TurtleBot-Mfg/turtlebot-doc-dev/README.md

root/usr/share/doc/turtlebot-dev/README.md
