TurtleBot-Mfg/turtlebot-doc-dev/root/usr/share/doc/turtlebot-dev/README.md

# TurtleBot Open Source Hardware Documentation and Documentation Source files
----
This pakage contains OSHW documentation
and source files to build .pdfs for user doumentation and assembly guides
