TurtleBot-Mfg/turtlebot-doc-dev/root/usr/share/doc/turtlebot-dev/TurtleBot 2 Hardware/Mechanical Drawings/PDF/IHE-0100-0003-3300.pdf

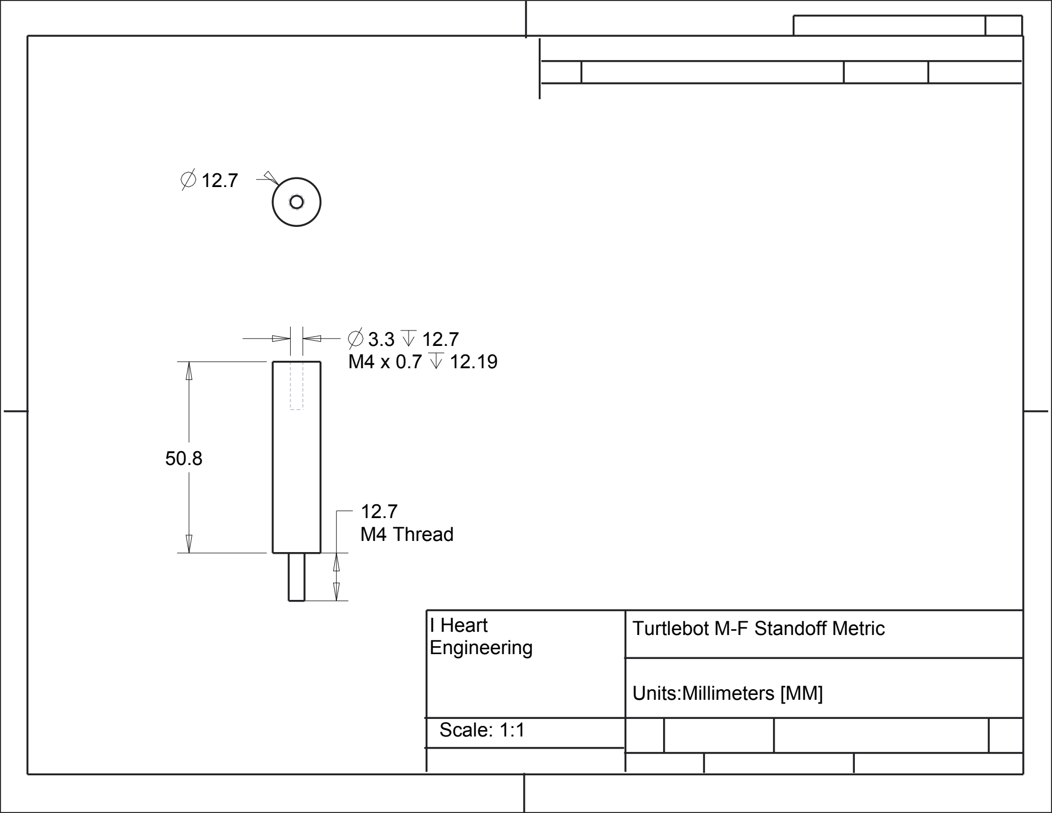
[picture p1: figure]
12.7 M4 Thread; I Heart; Turtlebot M-F Standoff Metric; Engineering; Units:Millimeters [MM]; Scale: 1:1
