TurtleBot-Mfg/turtlebot-doc-dev/root/usr/share/doc/turtlebot-dev/TurtleBot 2 Hardware/CAD Models/STEP/ITurtleBot2_plate1_HE-0102-000C-0000.stp

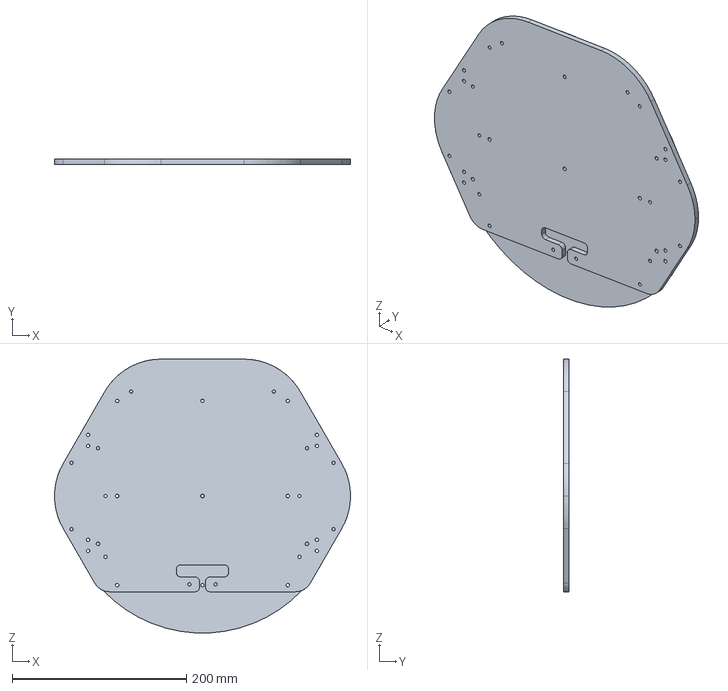
[picture p2: CAD file, 2013-01-17]
root/usr/share/doc/turtlebot-dev/TurtleBot 2 Hardware/CAD Models/STEP/ITurtleBot2_plate1_HE-0102-000C-0000.stp
340.0 x 6.40 x 314.5 mm
