TurtleBot-Mfg/turtlebot-doc-dev/root/usr/share/doc/turtlebot-dev/TurtleBot 2 Hardware/CAD Models/STL/IHE-0102-000C-0000.stl

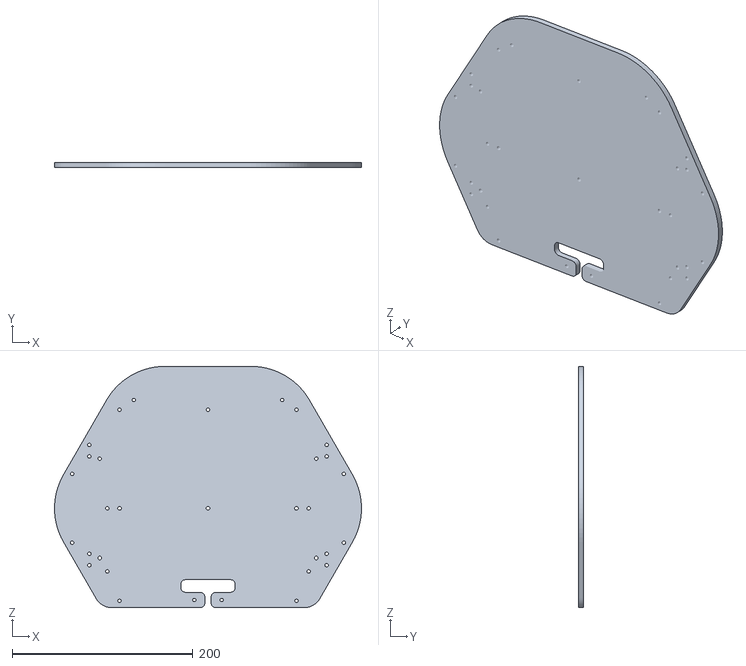
[picture p3: CAD file, 2013-01-17]
root/usr/share/doc/turtlebot-dev/TurtleBot 2 Hardware/CAD Models/STL/IHE-0102-000C-0000.stl
340.0 x 6.00 x 267.3
