TurtleBot-Mfg/turtlebot-doc-dev/root/usr/share/doc/turtlebot-dev/TurtleBot 2 Hardware/CAD Models/STEP/IHE-0100-0006-5300.stp

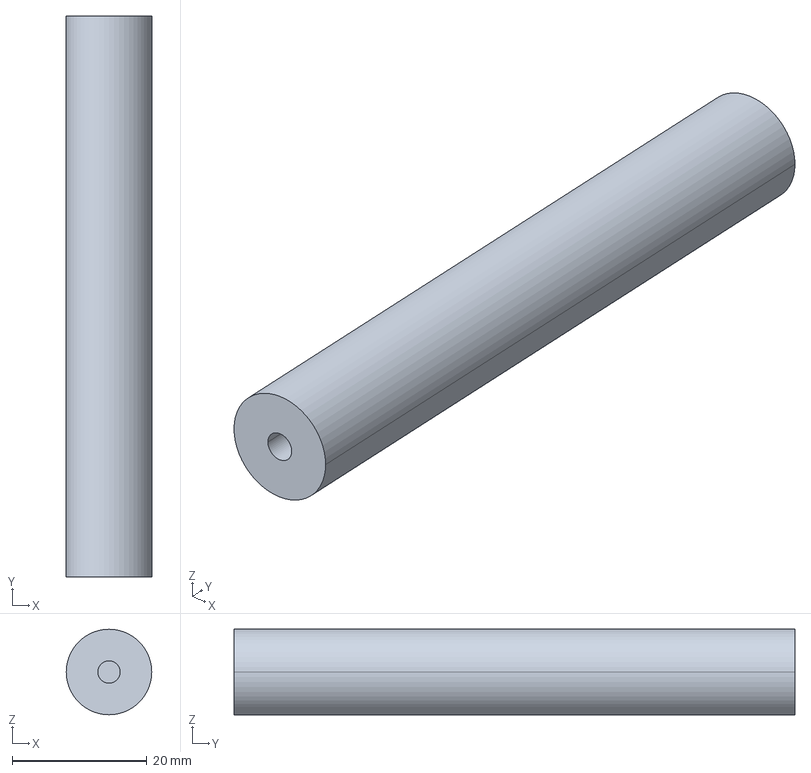
[picture p5: CAD file, 2013-01-17]
root/usr/share/doc/turtlebot-dev/TurtleBot 2 Hardware/CAD Models/STEP/IHE-0100-0006-5300.stp
12.7 x 83.3 x 12.7 mm
