TurtleBot-Mfg/turtlebot-doc-dev/root/usr/share/doc/turtlebot-dev/TurtleBot 2 Hardware/CAD Models/STEP/IHE-0100-0004-CB00.stp

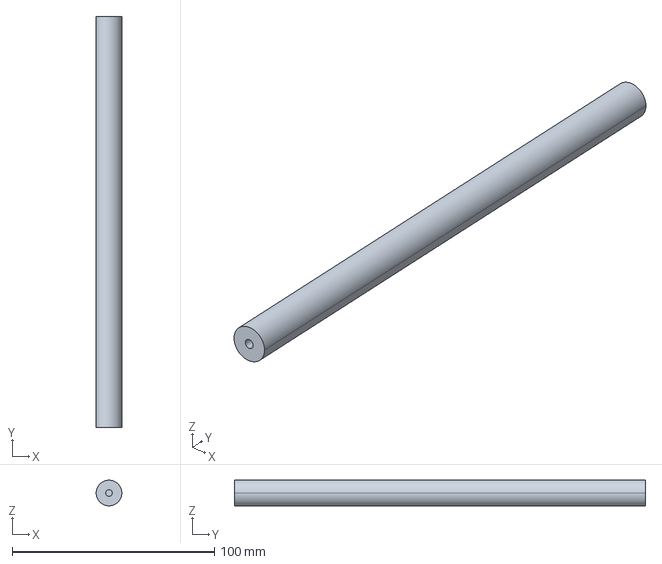
[picture p6: CAD file, 2013-01-17]
root/usr/share/doc/turtlebot-dev/TurtleBot 2 Hardware/CAD Models/STEP/IHE-0100-0004-CB00.stp
12.7 x 203.2 x 12.7 mm
