TurtleBot-Mfg/turtlebot-doc-dev/root/usr/share/doc/turtlebot-dev/TurtleBot 2 Hardware/CAD Models/STEP/IHE-0102-000E-0000.stp

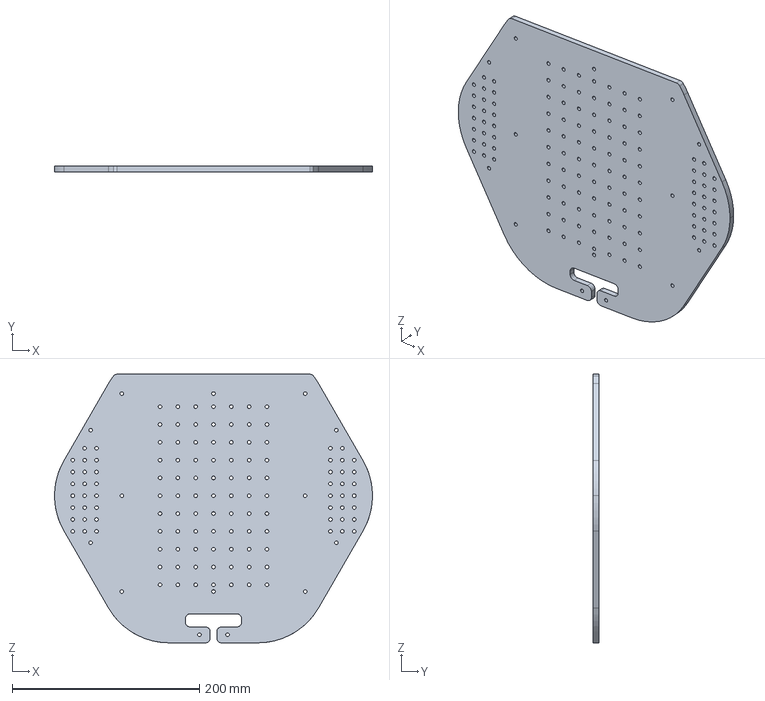
[picture p7: CAD file, 2013-01-17]
root/usr/share/doc/turtlebot-dev/TurtleBot 2 Hardware/CAD Models/STEP/IHE-0102-000E-0000.stp
340.0 x 6.00 x 287.3 mm
