TurtleBot-Mfg/turtlebot-doc-dev/root/usr/share/doc/turtlebot-dev/TurtleBot 2 Hardware/CAD Models/STEP/IHE-0100-0005-2700.stp

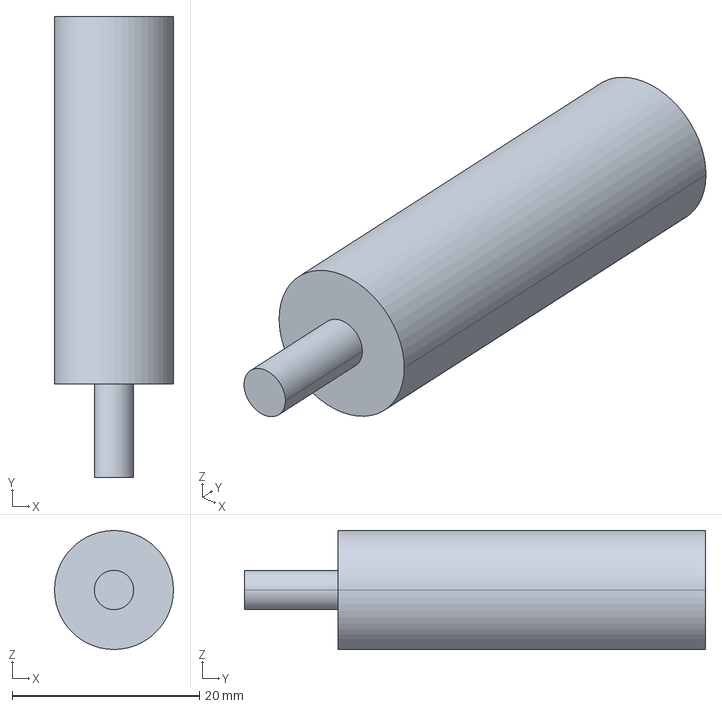
[picture p8: CAD file, 2013-01-17]
root/usr/share/doc/turtlebot-dev/TurtleBot 2 Hardware/CAD Models/STEP/IHE-0100-0005-2700.stp
12.7 x 49.2 x 12.7 mm
