TurtleBot-Mfg/turtlebot-doc-dev/(list of files, cad)

Other CAD files:
root/usr/share/doc/turtlebot-dev/TurtleBot 2 Hardware/CAD Models/STL/IHE-0100-0003-3300.stl
root/usr/share/doc/turtlebot-dev/TurtleBot 2 Hardware/CAD Models/STL/IHE-0100-0004-CB00.stl
root/usr/share/doc/turtlebot-dev/TurtleBot 2 Hardware/CAD Models/STL/IHE-0100-0005-2700.stl
root/usr/share/doc/turtlebot-dev/TurtleBot 2 Hardware/CAD Models/STL/IHE-0100-0006-5300.stl
root/usr/share/doc/turtlebot-dev/TurtleBot 2 Hardware/CAD Models/STL/IHE-0102-000D-0000.stl
root/usr/share/doc/turtlebot-dev/TurtleBot 2 Hardware/CAD Models/STL/IHE-0102-000E-0000.stl
