TurtleBot-Mfg/turtlebot-doc-dev/root/usr/share/doc/turtlebot-dev/TurtleBot 2 Hardware/Manuals/cable assembly manual.odt

# Turtlebot-Laptop Power Cable Assembly Instructions

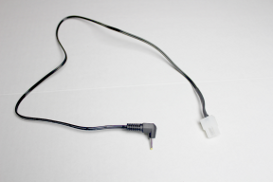
[picture p10: figure]

Includes: -Power Cable -2 Connector Pins -Heat Shrink -Molex 6 Pos Connector

Step 1) Cut Laptop Power Supply to a length of 2'.

Step 2) Strip the ends of the wires to .35”.

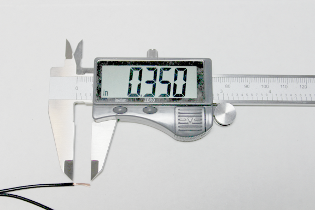
[picture p11: figure]

Step 3) Cut approximately 1.5” of heat shrink and put it over the cut wire, DO NOT HEAT YET.

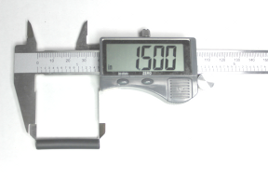
[picture p12: figure]

Step 4) Insert the wires into the connector pins. Make sure the wire casing stops within the central channel. Next, crimp the clips around the exposed copper wire and the center clips. Do not crimp the 3rd clip pair.

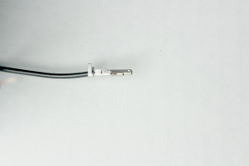
[picture p13: figure]

Step 5) Insert the ground pin into the middle hole next to the clip on your Molex connector, make sure “up” on the pin is aligned with the plastic clip. You can use a screwdriver to push it in until it clicks.

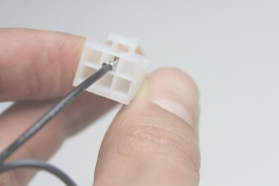
[picture p14: figure]

Step 6) Insert VCC pin directly below the ground pin.

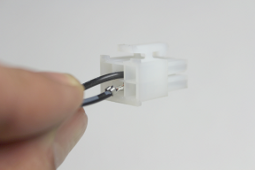
[picture p15: figure]

Step 7) Bring heat shrink up to the Molex connector and apply even heat.

CONGRATULATIONS!!!! You have completed your Turtlebot to Laptop Power Cable!!!!

TURTLEBOT-LAPTOP POWER CABLE Ver. 0.1

Copyright © 2013 I Heart Engineering. All Rights Reserved LAPTOP-POWER CABLE Page 2/5

Copyright © 2013 I Heart Engineering. All Rights Reserved LAPTOP-POWER CABLE Page 1/5
