TurtleBot-Mfg/turtlebot-doc-dev/root/usr/share/doc/turtlebot-dev/TurtleBot 2 Hardware/Assembly Guide/TurtleBot_QuickStart_pg3.pdf

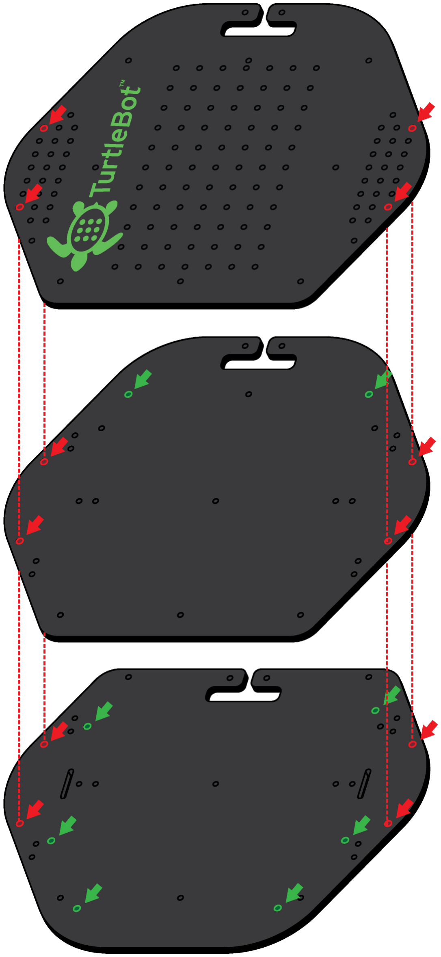
[picture p32: figure]
