TurtleBot-Mfg/turtlebot-doc-dev/root/usr/share/doc/turtlebot-dev/TurtleBot 2 Hardware/Assembly Guide/TurtleBot_QuickStart_pg6.pdf

== Links ==
http://www.turtlebot.com/
https://kforge.ros.org/cgi-bin/mailman/listinfo/turtlebot-usershttp://www.ros.org/wiki/
http://www.ros.org/wiki/Robots/TurtleBothttps://github.com/ros
https://github.com/IHeartRobotics/TurtleBothttp://learn.iheartengineering.com/wiki/Main_Pagehttp://store.iheartengineering.com/http://www.iheartrobotics.com/http://w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
