TurtleBot-Mfg/turtlebot-doc-dev/root/usr/share/doc/turtlebot-dev/TurtleBot 2 Hardware/Assembly Guide/TurtleBot_QuickStart_pg7.pdf

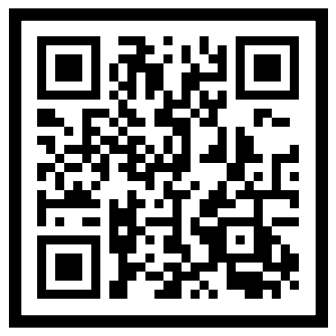
[picture p33: figure]
