TurtleBot-Mfg/turtlebot-doc-dev/root/usr/share/doc/turtlebot-dev/TurtleBot 2 Hardware/Assembly Guide/TurtleBot_QuickStart_pg4.pdf

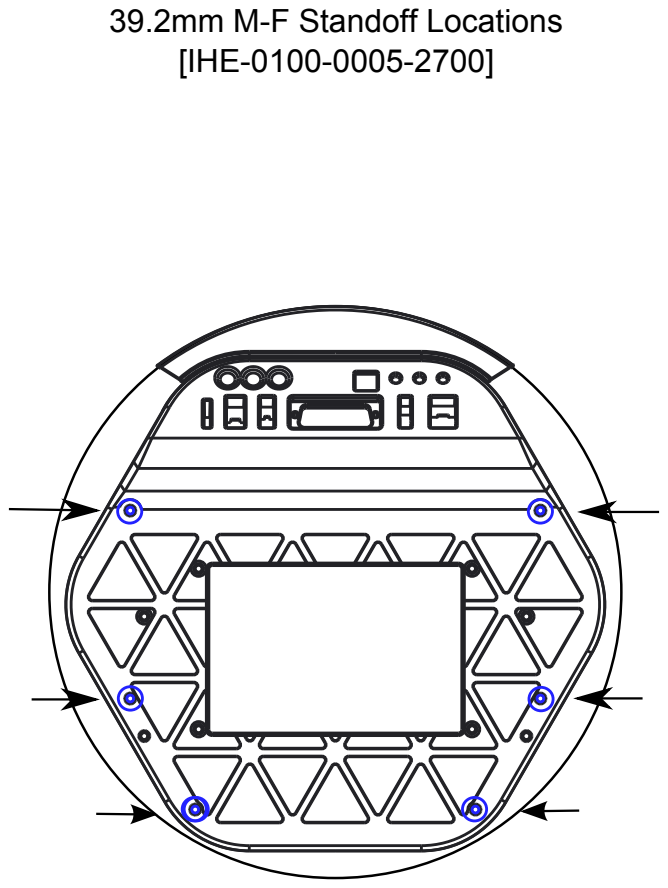
[picture p34: page 1]
39.2mm M-F Standoff Locations [IHE-0100-0005-2700]
