TurtleBot-Mfg/turtlebot-doc-dev/root/usr/share/doc/turtlebot-dev/TurtleBot 2 Hardware/Assembly Guide/TurtleBot_QuickStart_pg5.pdf

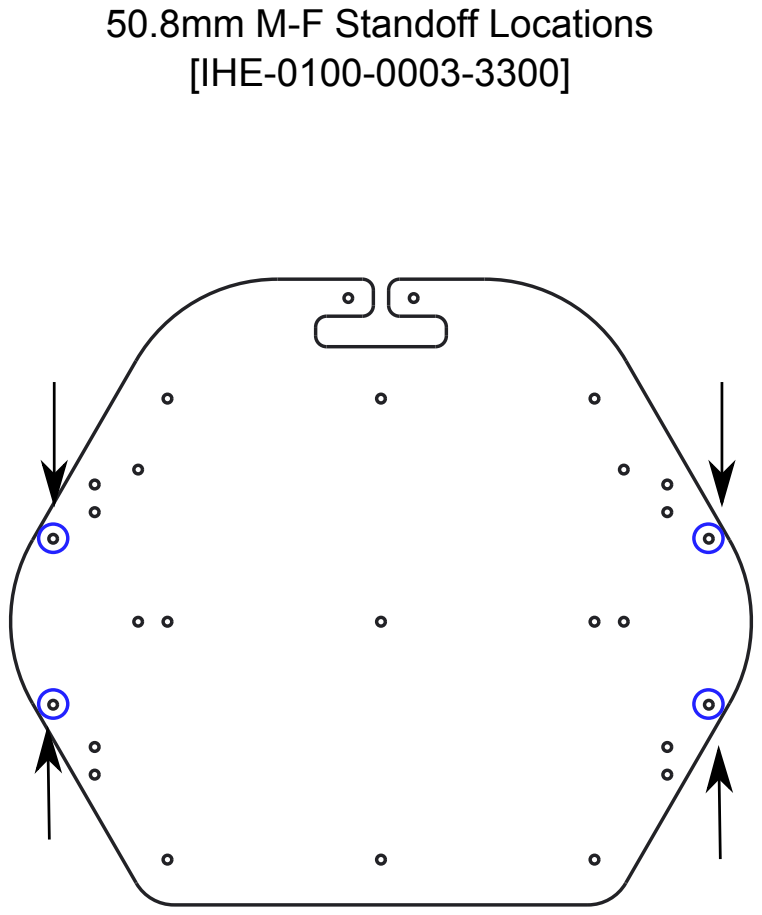
[picture p35: page 1]
50.8mm M-F Standoff Locations [IHE-0100-0003-3300]
