TurtleBot-Mfg/turtlebot-doc-dev/root/usr/share/doc/turtlebot-dev/TurtleBot 2 Hardware/Mechanical Drawings/PDF/IHE-0100-0004-CB00.pdf

# 12.7 NOM

## IHE-0100-0004-CB00 1

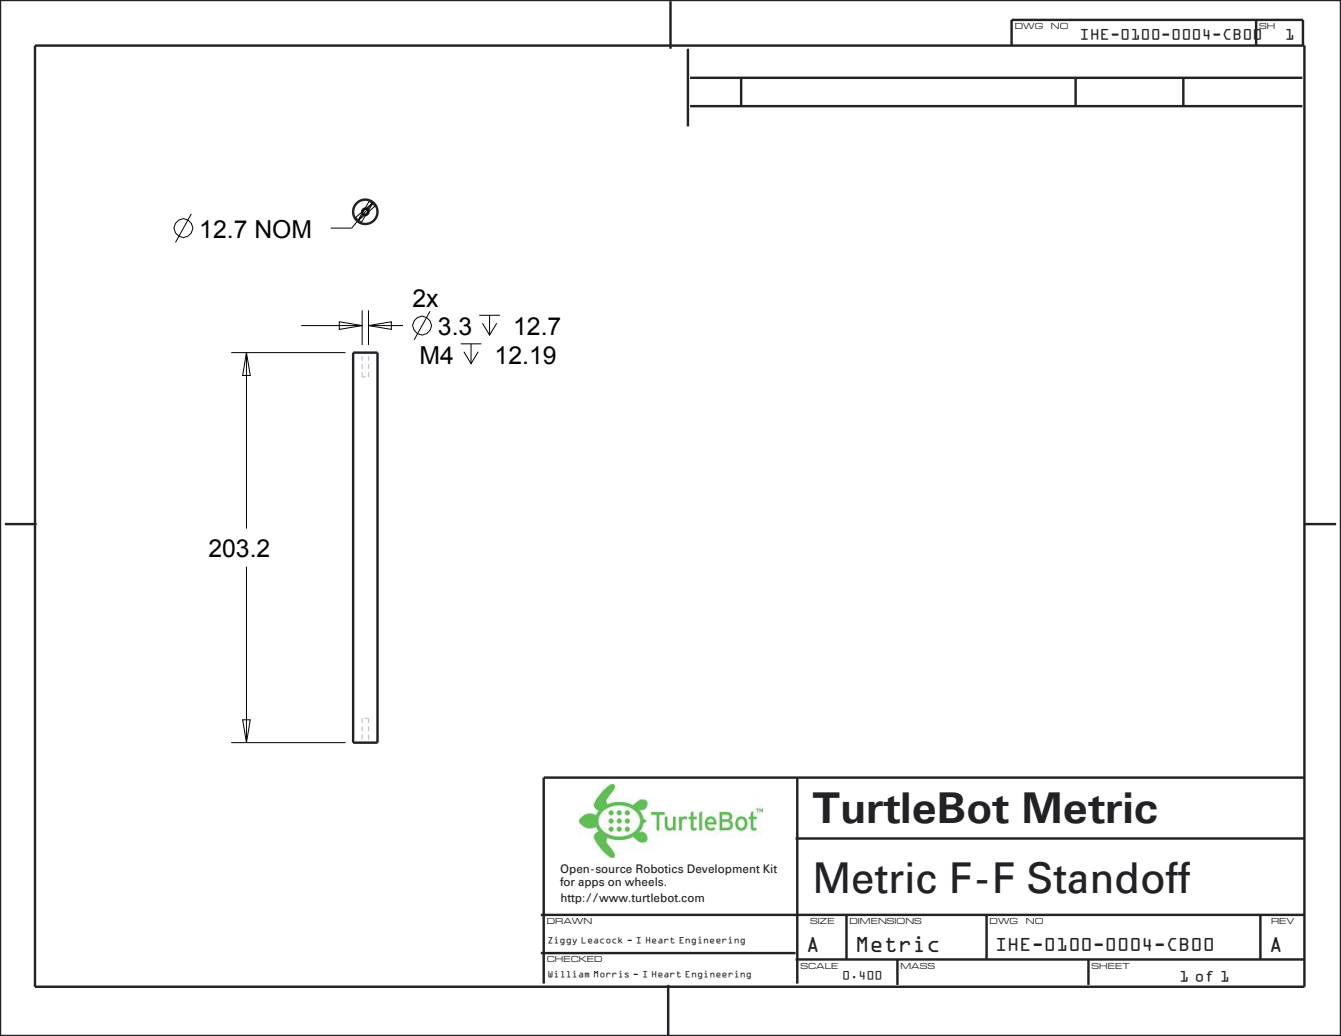
[picture p36: page 1]
DRAWN; SIZE; DWG NO; REV; SCALE; SHEET; DIMENSIONS; MASS; Metric F-F Standoff; Metric; IHE-0100-0004-CB00; TurtleBot Metric

Open-source Robotics Development Kit
for apps on wheels.
http://www.turtlebot.com

A CHECKED
Ziggy Leacock - I Heart Engineering

William Morris - I Heart Engineering
