TurtleBot-Mfg/turtlebot-doc-dev/root/usr/share/doc/turtlebot-dev/TurtleBot 2 Hardware/Mechanical Drawings/PDF/IHE-0100-0005-2700.pdf

12.7

# IHE-0100-0003-3301 1

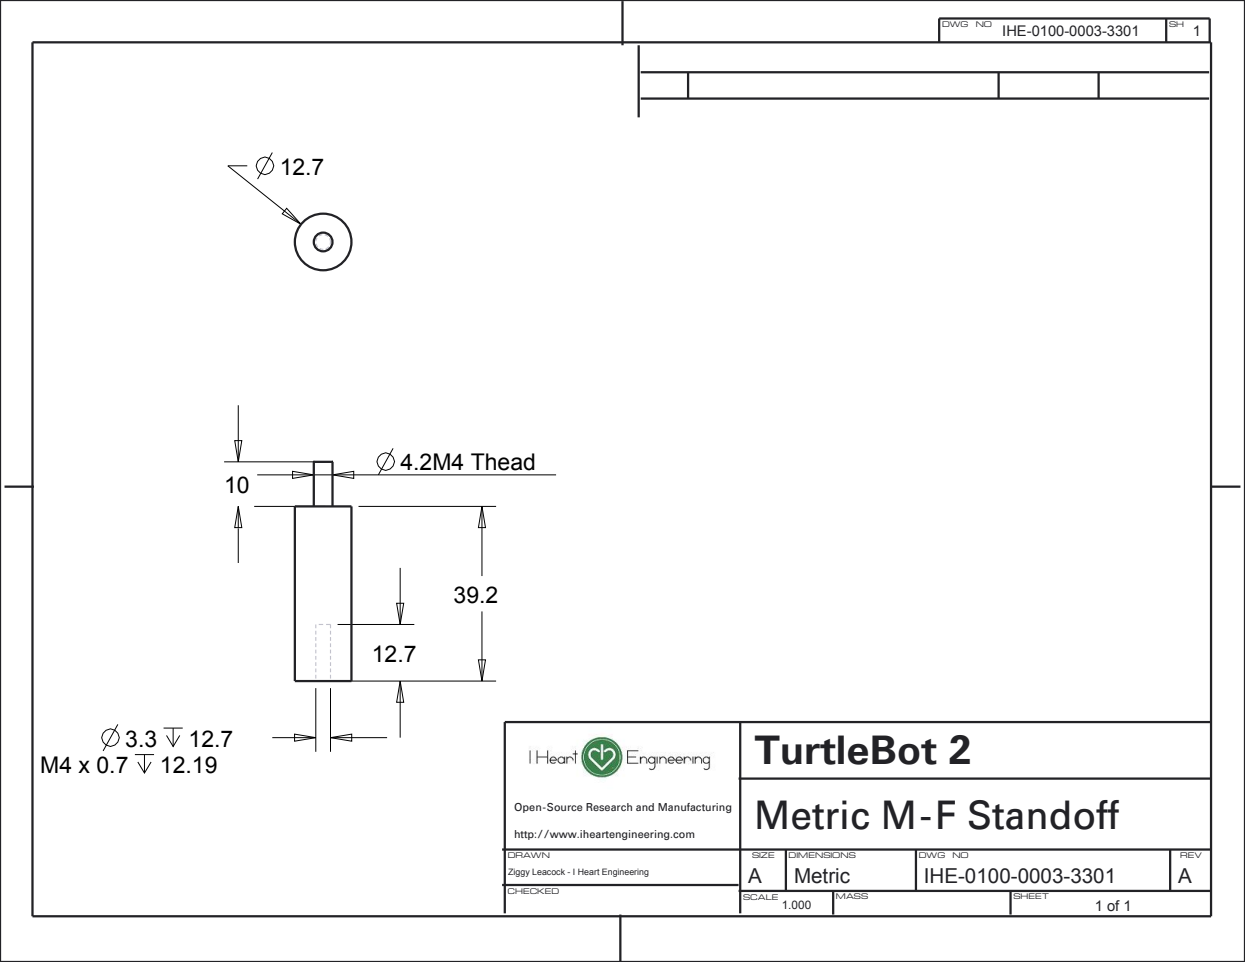
[picture p37: page 1]
DRAWN; SIZE; DWG NO; REV; SCALE; SHEET; DIMENSIONS; MASS; 4.2M4 Thead; Metric M-F Standoff; Metric; IHE-0100-0003-3301; TurtleBot 2

Open-Source Research and Manufacturing

http://www.iheartengineering.com

A CHECKED
Ziggy Leacock - I Heart Engineering
