TurtleBot-Mfg/turtlebot-doc-dev/root/usr/share/doc/turtlebot-dev/TurtleBot 2 Hardware/Mechanical Drawings/PDF/IHE-0100-0006-5300.pdf

# 12.7[1/2] NOM

3.3 12.7

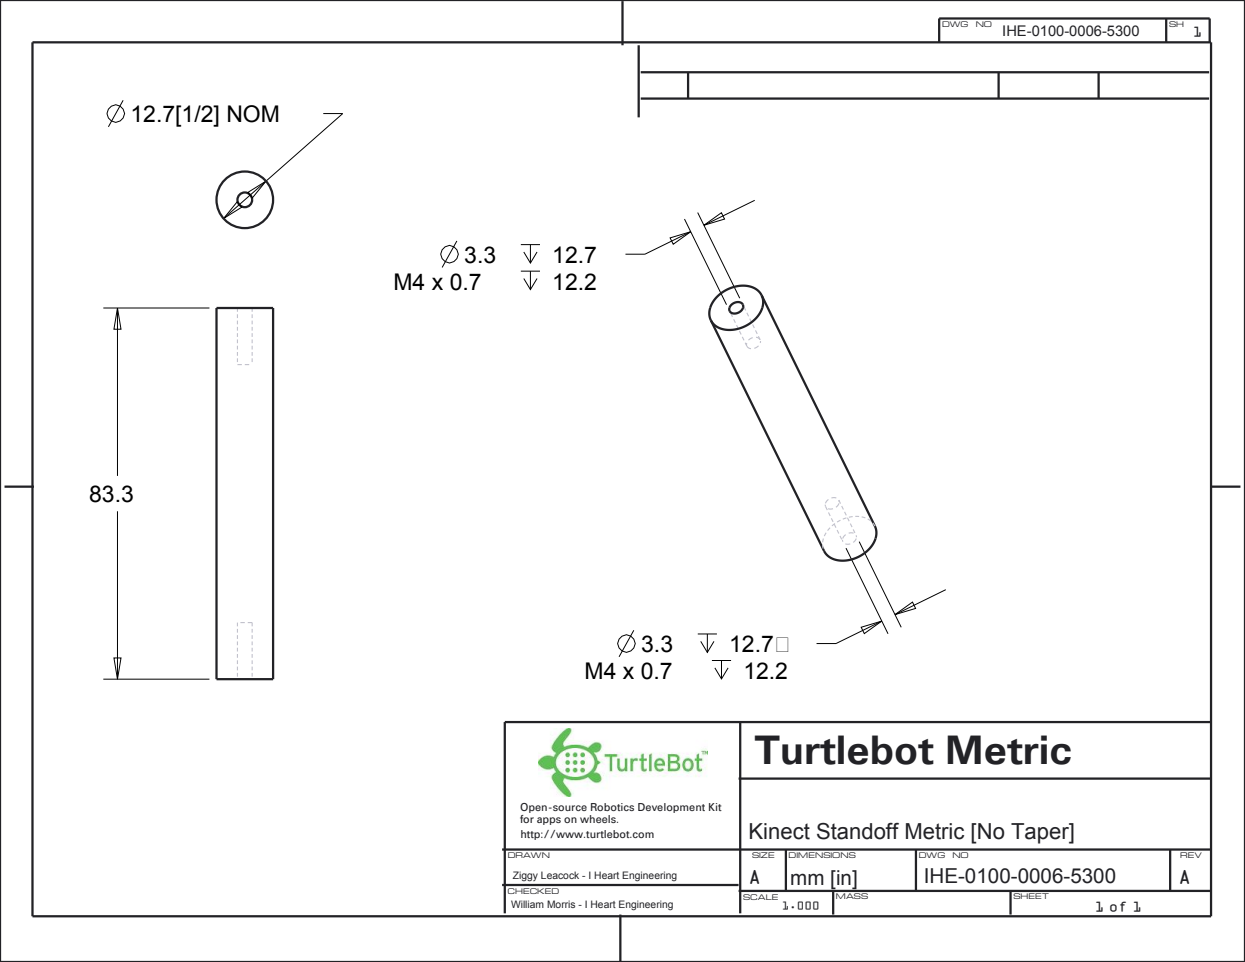
[picture p38: page 1]
DRAWN; SIZE; DWG NO; REV; SCALE; SHEET; DIMENSIONS; MASS; IHE-0100-0006-5300; Turtlebot Metric

Open-source Robotics Development Kit
for apps on wheels.
http://www.turtlebot.com

Kinect Standoff Metric [No Taper]

A CHECKED
Ziggy Leacock - I Heart Engineering

William Morris - I Heart Engineering
