TurtleBot-Mfg/turtlebot-doc-dev/root/usr/share/doc/turtlebot-dev/TurtleBot 2 Hardware/Mechanical Drawings/PDF/IHE-0102-000C-0000.pdf

102.44

110

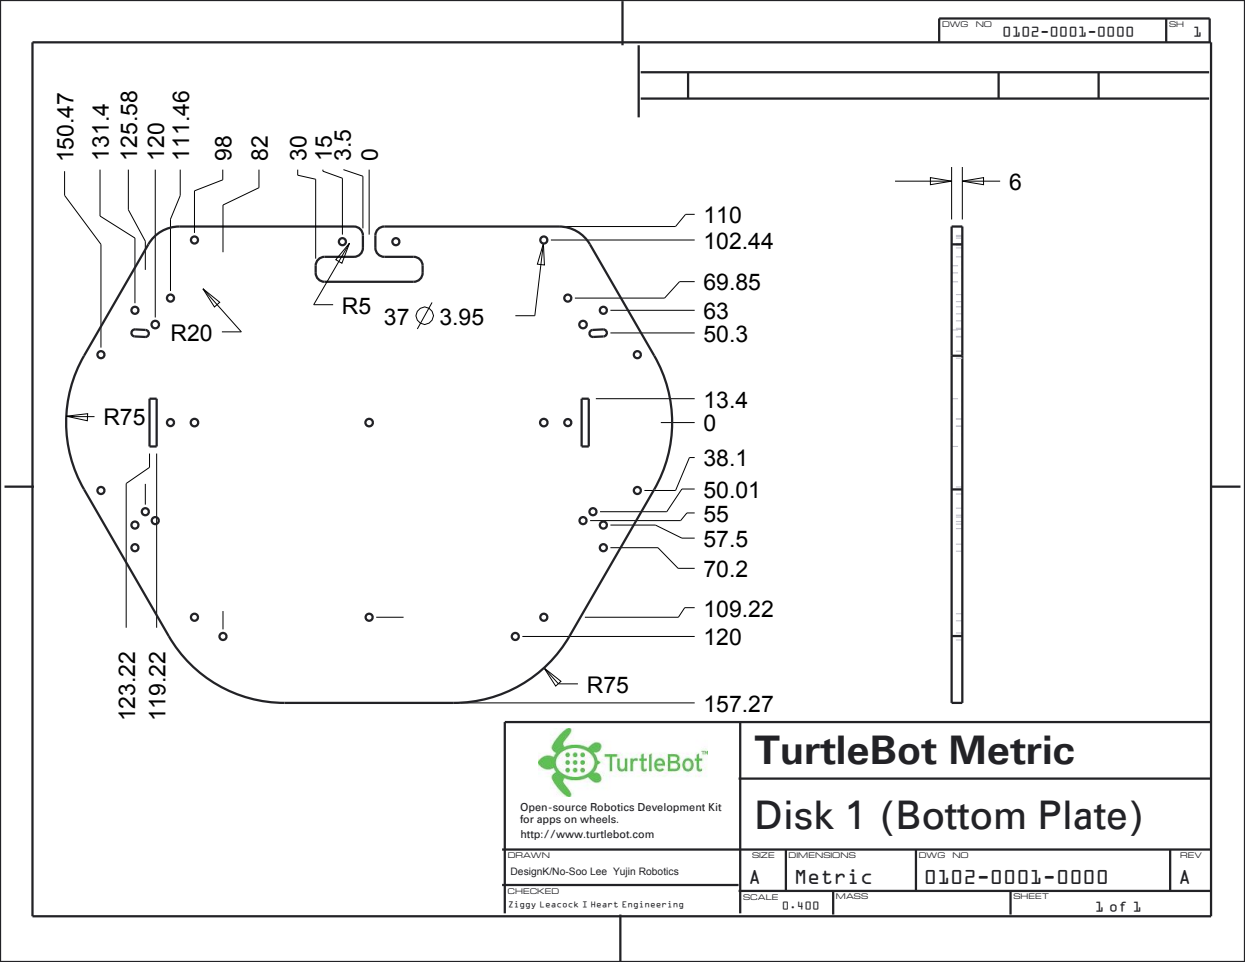
[picture p39: page 1]
DRAWN; SIZE; DWG NO; REV; SCALE; SHEET; DIMENSIONS; MASS; Metric

TurtleBot Metric
Disk 1 (Bottom Plate)

Open-source Robotics Development Kit
for apps on wheels.
http://www.turtlebot.com

A CHECKED
DesignK/No-Soo Lee Yujin Robotics

Ziggy Leacock I Heart Engineering
