TurtleBot-Mfg/turtlebot-doc-dev/root/usr/share/doc/turtlebot-dev/TurtleBot 2 Hardware/Mechanical Drawings/PDF/IHE-0102-000D-0000.pdf

148.6

157.27

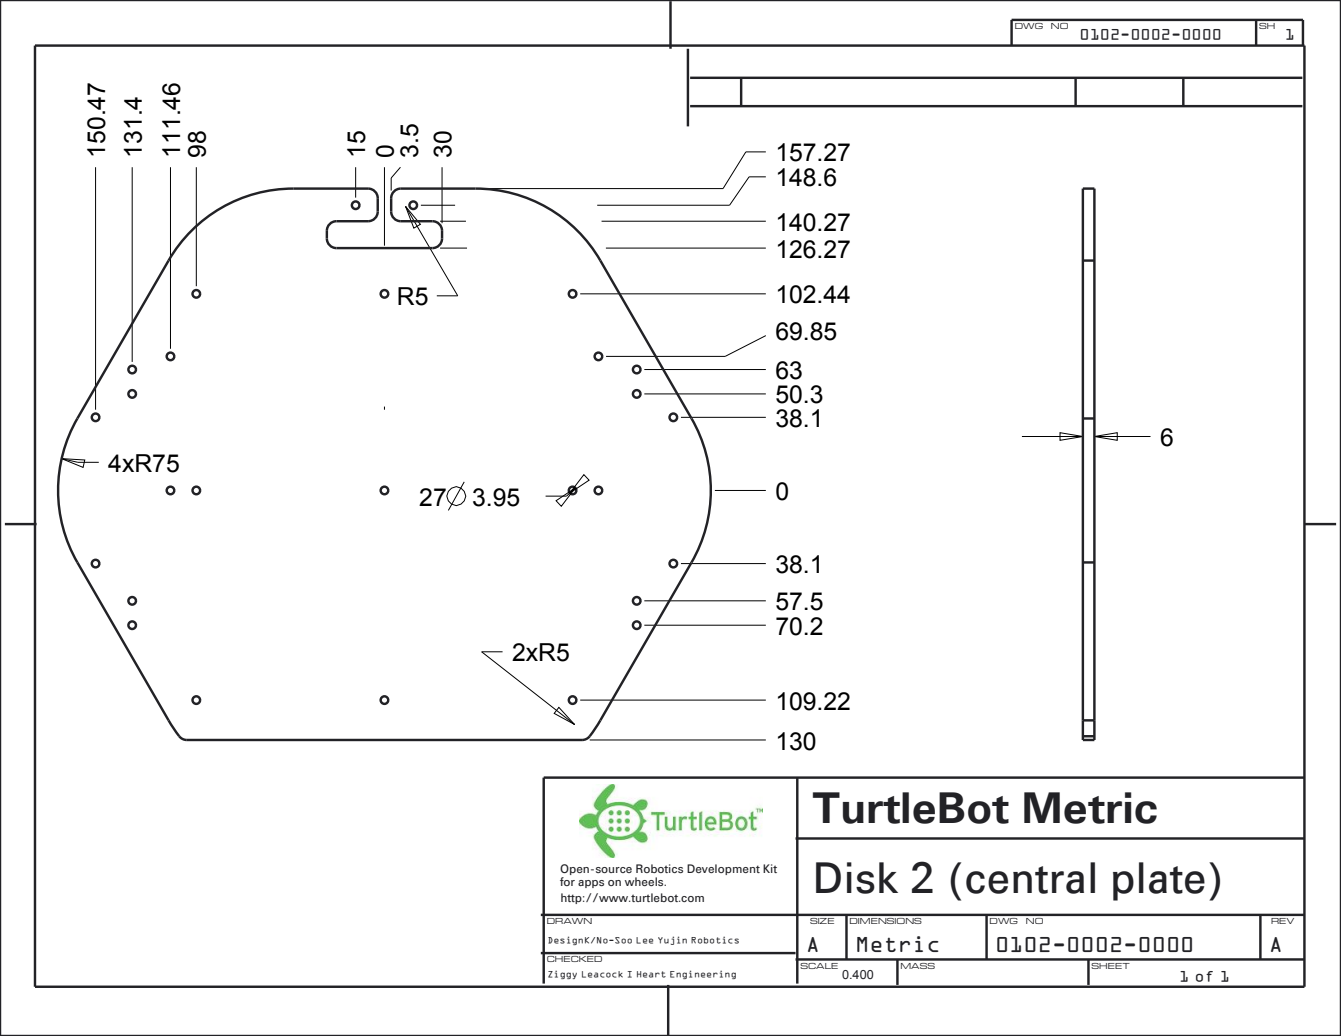
[picture p40: page 1]
DRAWN; SIZE; DWG NO; REV; SCALE; SHEET; DIMENSIONS; MASS; Disk 2 (central plate); Metric; TurtleBot Metric

Open-source Robotics Development Kit
for apps on wheels.
http://www.turtlebot.com

A CHECKED
DesignK/No-Soo Lee Yujin Robotics

Ziggy Leacock I Heart Engineering
