TurtleBot-Mfg/turtlebot-doc-dev/root/usr/share/doc/turtlebot-dev/TurtleBot 2 Hardware/Mechanical Drawings/PDF/IHE-0102-000E-0000.pdf

148.6

102.44

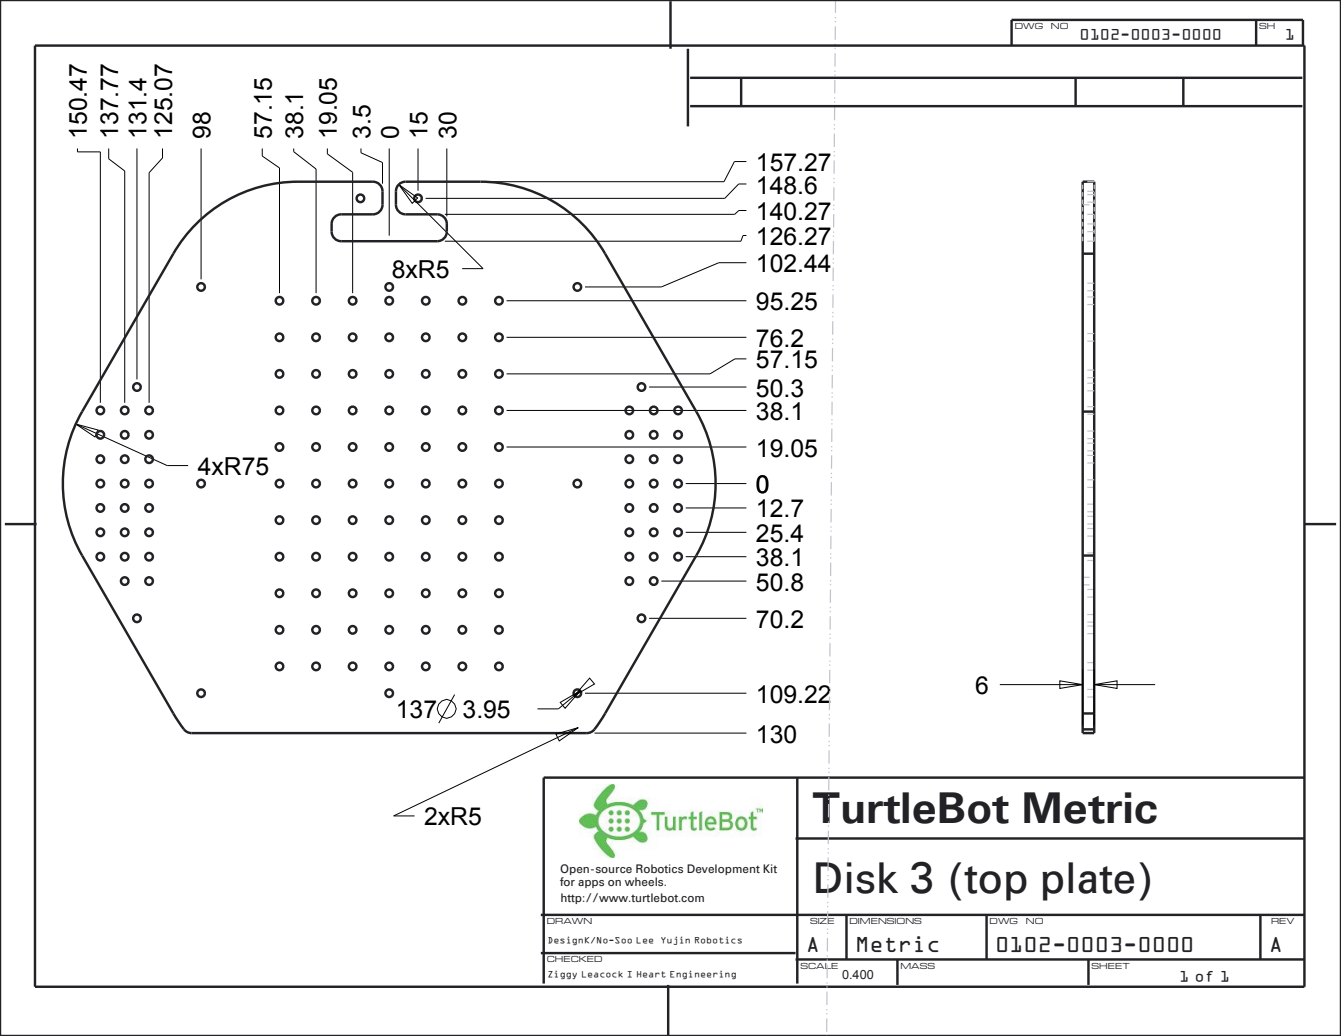
[picture p41: page 1]
DRAWN; SIZE; DWG NO; REV; SCALE; SHEET; DIMENSIONS; MASS; Disk 3 (top plate); Metric; TurtleBot Metric

Open-source Robotics Development Kit
for apps on wheels.
http://www.turtlebot.com

A CHECKED
DesignK/No-Soo Lee Yujin Robotics

Ziggy Leacock I Heart Engineering
