TurtleBot-Mfg/turtlebot-doc-dev/root/usr/share/doc/turtlebot-dev/TurtleBot 2 Hardware/Assembly Guide/inkscape files/TurtleBot_QuickStart_pg1-2.pdf

# Quick Start Guide

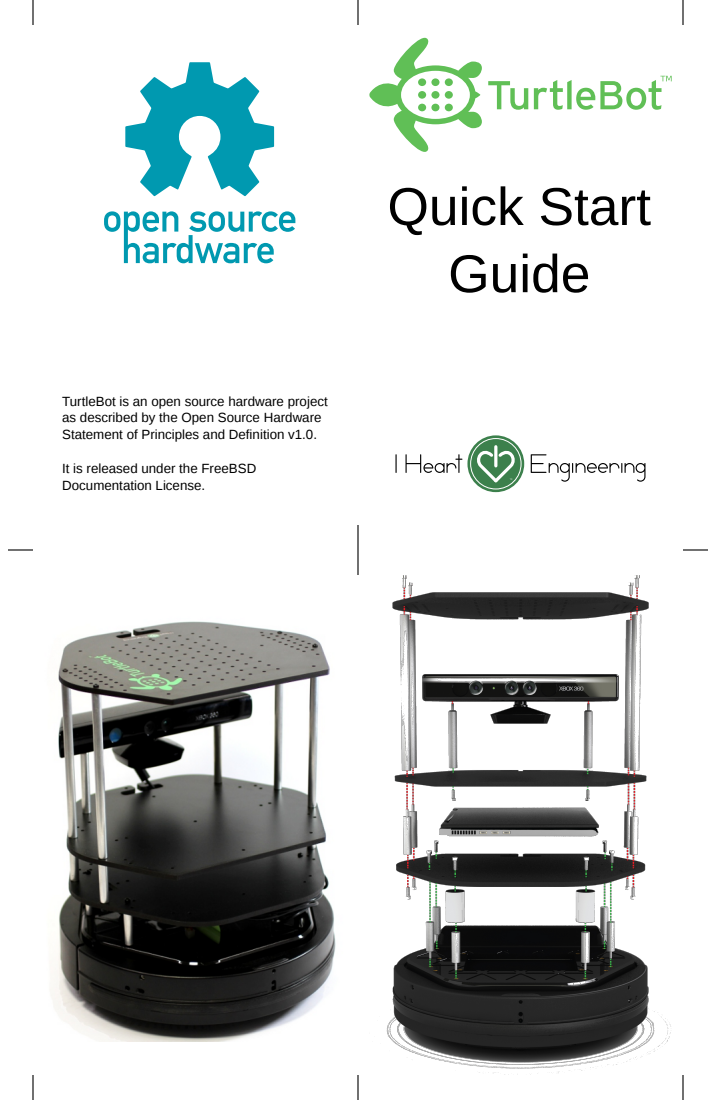
[picture p44: page 1]

TurtleBot is an open source hardware project
as described by the Open Source Hardware
Statement of Principles and Definition v1.0.

It is released under the FreeBSD
Documentation License.

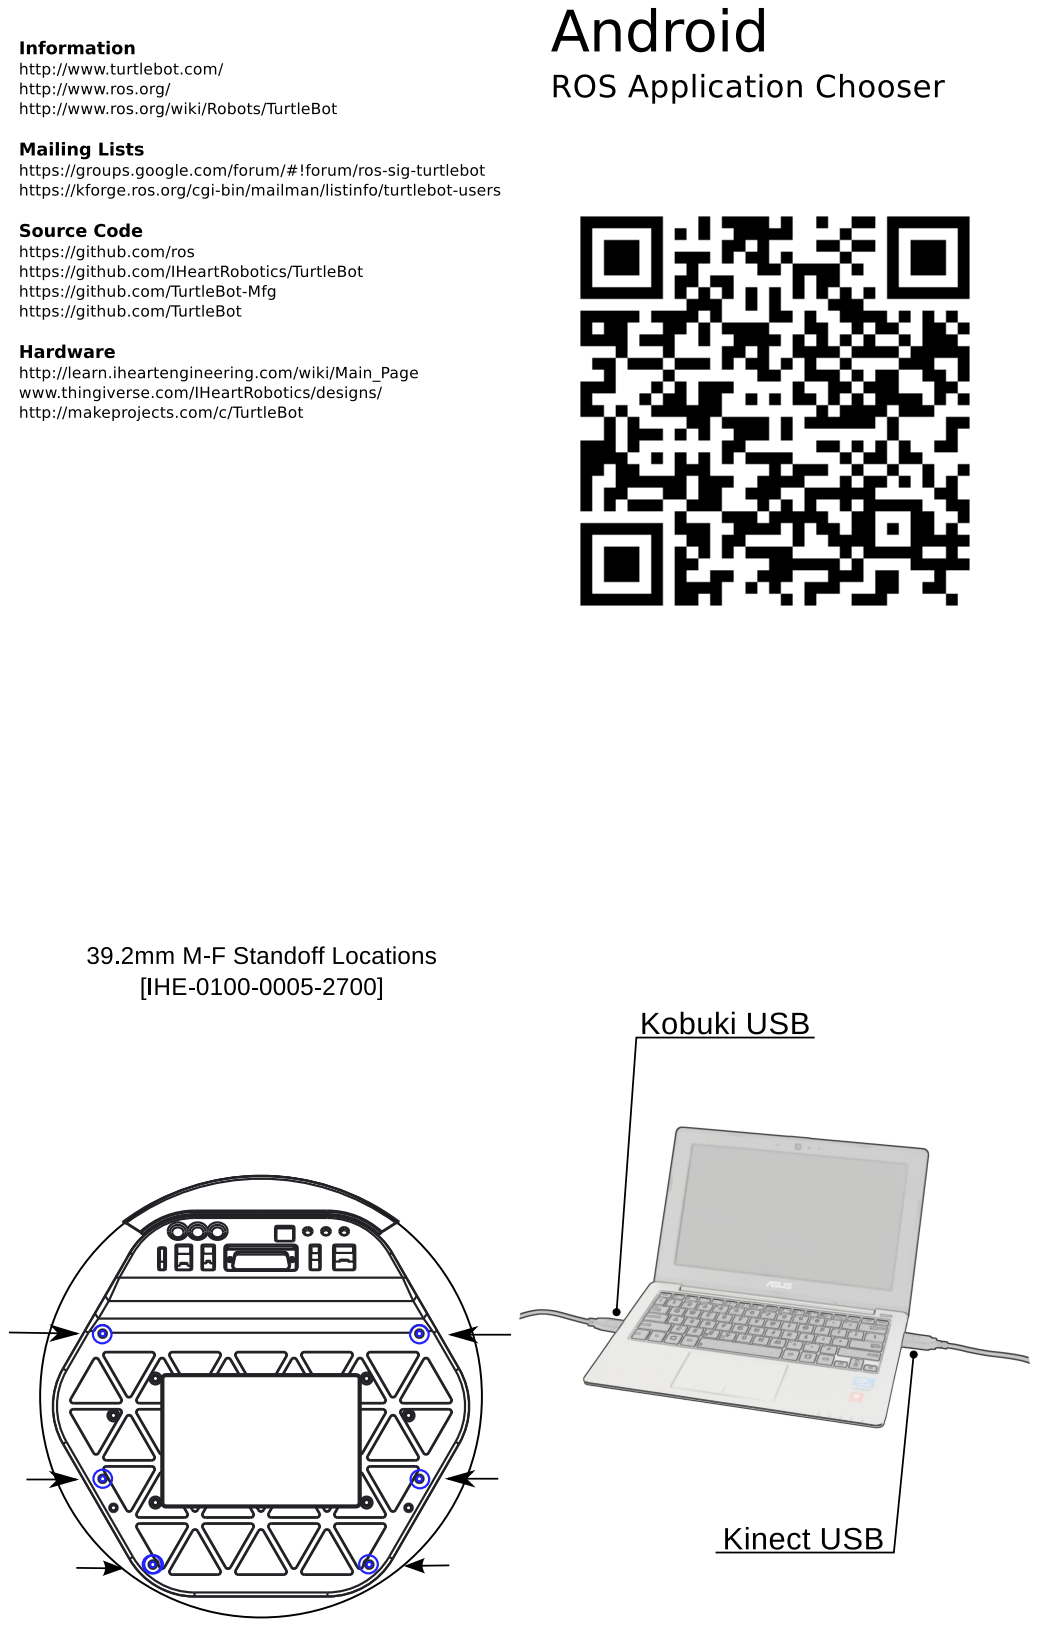
[picture p45: page 2]
