TurtleBot-Mfg/turtlebot-doc-dev/(commit log)

2013-01-17 TurtleBot2 Open Source Hardware Documentation
    This is the Dev versions of the OSHD. It contains the basic outline +
    majority of content. It is missing the completed Full Assembly Guide
    and edited 'Get Started' HTML page.
    [IHE-0100-0003-3300.stl, IHE-0100-0003-3300.stp, IHE-0100-0004-CB00.stl, IHE-0100-0004-CB00.stp, IHE-0100-0005-2700.stl, IHE-0100-0005-2700.stp, IHE-0100-0006-5300.stl, IHE-0100-0006-5300.stp]
2013-01-17 Re-Commit I think
    Should be a re-commit? of the OSHW Docs
    [IHE-0100-0003-3300.stl, IHE-0100-0003-3300.stp, IHE-0100-0004-CB00.stl, IHE-0100-0004-CB00.stp, IHE-0100-0005-2700.stl, IHE-0100-0005-2700.stp, IHE-0100-0006-5300.stl, IHE-0100-0006-5300.stp]
2013-01-17 TurtleBot2 Open Source Hardware Documentation
    Contains OSHD for TurtleBot 2. Is currently missing updated 'Get
    Started' Page and TurtleBot 2 Full Assembly Manual.
    [IHE-0100-0003-3300.stl, IHE-0100-0003-3300.stp, IHE-0100-0004-CB00.stl, IHE-0100-0004-CB00.stp, IHE-0100-0005-2700.stl, IHE-0100-0005-2700.stp, IHE-0100-0006-5300.stl, IHE-0100-0006-5300.stp]
2013-01-17 TurtleBot2 OSHW Documentation Update
    Deleted Extra directory.
    Added .doc file for TurtleBot 2 Assembly Manual
    Added .pdf file for TurtleBot 2 Assembly Manual
    [IHE-0100-0003-3300.stl, IHE-0100-0003-3300.stp, IHE-0100-0004-CB00.stl, IHE-0100-0004-CB00.stp, IHE-0100-0005-2700.stl, IHE-0100-0005-2700.stp, IHE-0100-0006-5300.stl, IHE-0100-0006-5300.stp]
2013-01-18 TurtleBot2 OSHW Documentation Update
    Added 'Manuals' directory for other manuals.
    Added 'Cable Assembly Manual' to Manuals
